HAMTEL77/Modey/case/Modey45_R2_BOTTOM_cover.step

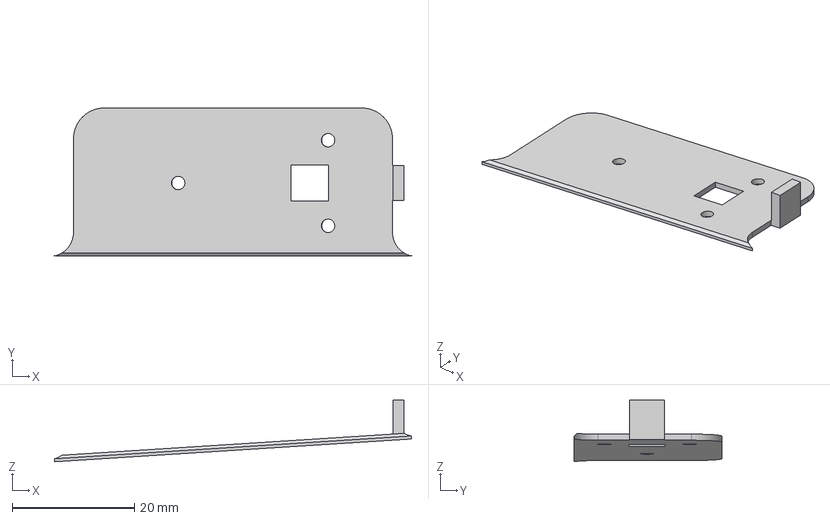
[picture p1: CAD file, 2026-07-26]
case/Modey45_R2_BOTTOM_cover.step
58.4 x 24.2 x 10.1 mm
