HAMTEL77/Modey/case/Modey45_L2_TOP.step

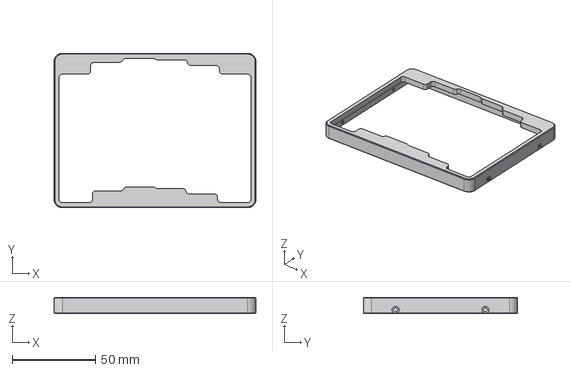
[picture p2: CAD file, 2026-07-26]
case/Modey45_L2_TOP.step
121.3 x 92.7 x 9.90 mm
