HAMTEL77/Modey/case/reset_sw.step

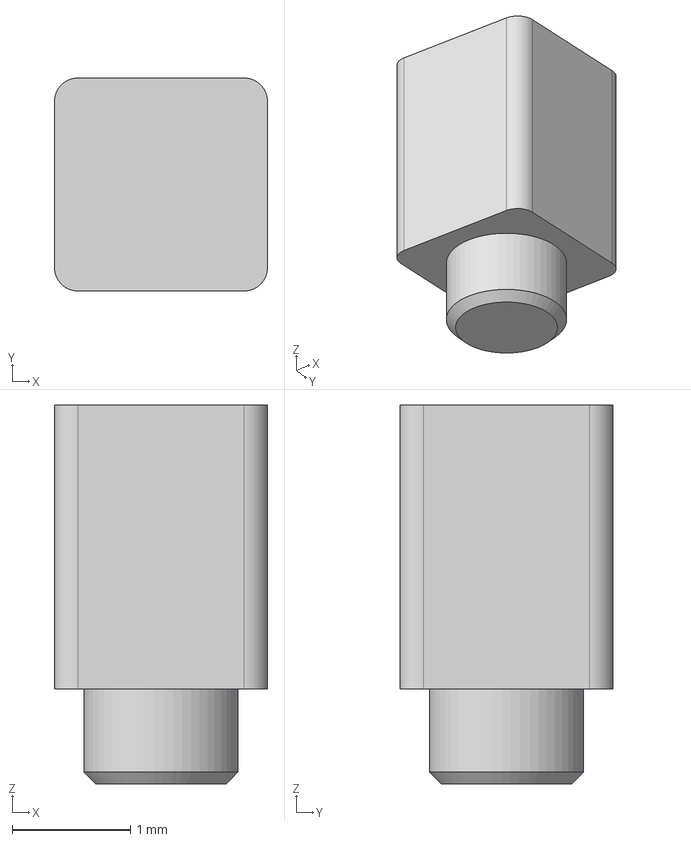
[picture p3: CAD file, 2026-07-26]
case/reset_sw.step
1.80 x 1.80 x 3.20 mm
