HAMTEL77/Modey/case/Modey45_R2_BOTTOM.step

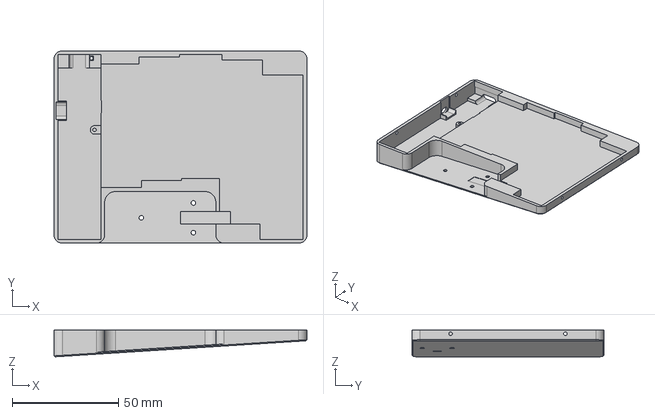
[picture p4: CAD file, 2026-07-26]
case/Modey45_R2_BOTTOM.step
119.1 x 90.5 x 12.6 mm
