HAMTEL77/Modey/case/Modey45_L2_PLATE.step

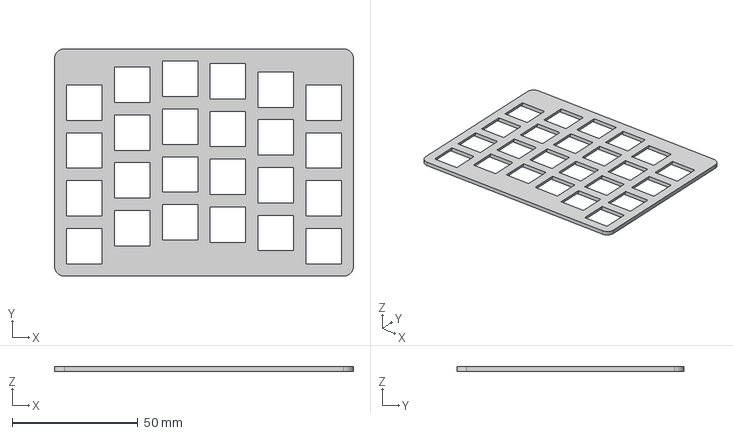
[picture p5: CAD file, 2026-07-26]
case/Modey45_L2_PLATE.step
119.1 x 90.5 x 2.00 mm
