HAMTEL77/Modey/case/power_sw.step

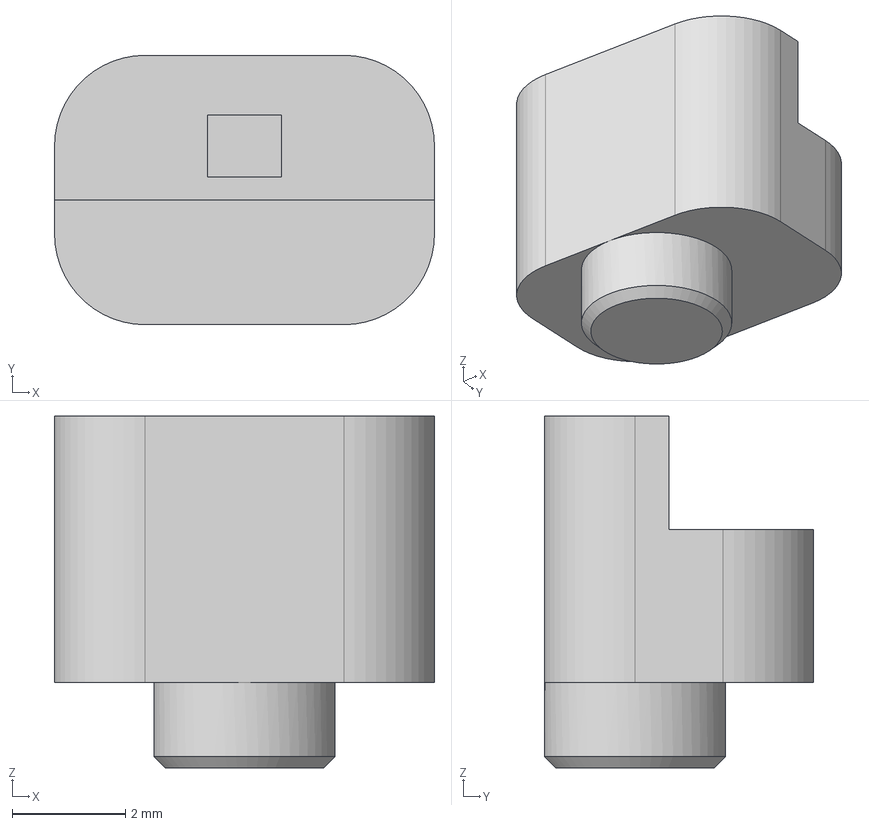
[picture p8: CAD file, 2026-07-26]
case/power_sw.step
6.70 x 4.75 x 6.20 mm
