HAMTEL77/Modey/case/19mm_C.step

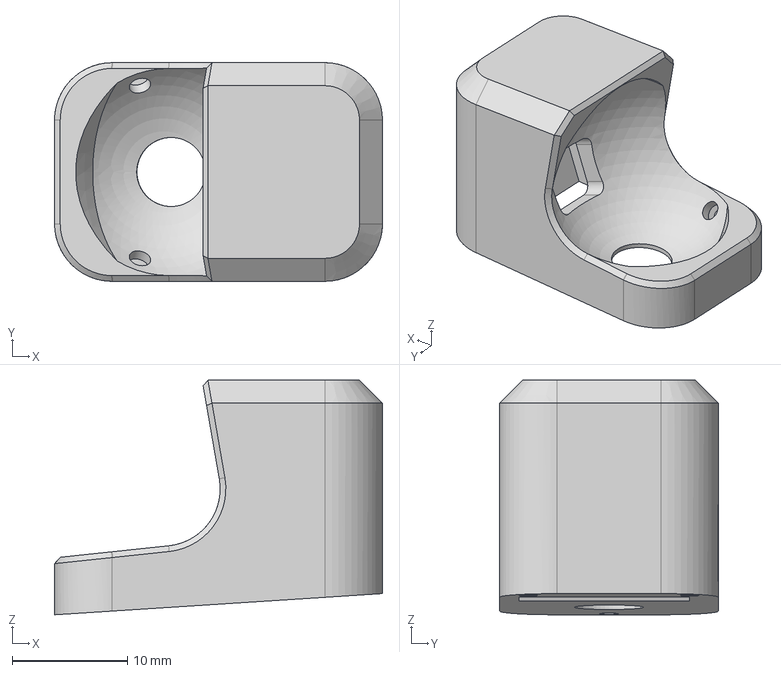
[picture p9: CAD file, 2026-07-26]
case/19mm_C.step
28.5 x 19.0 x 20.4 mm
