HAMTEL77/Modey/(list of files, cad)

Other CAD files:
case/Modey45_R2_TOP.step
