HAMTEL77/Modey/pcb/PAW3222/PAW3222.kicad_pcb

## KiCad design pcb/PAW3222/PAW3222.kicad_pcb (2026-07-26)

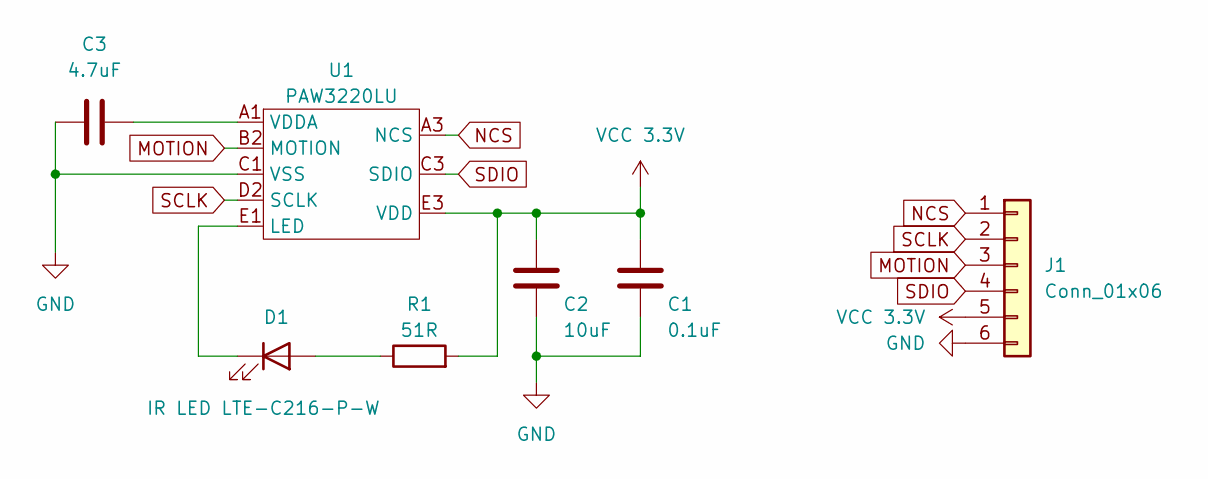
[picture p10: schematic PAW3222.kicad_sch]

Parts:
C1: 0.1uF; C_0402_1005Metric
C2: 10uF; C_0402_1005Metric
C3: 4.7uF; C_0402_1005Metric
D1: IR LED LTE-C216-P-W; LTE-C216-P-W; LCSC C2942980
J1: Conn_01x06; CONN_FH19C-6S-0.5SH10_HIR
R1: 51R; R_0402_1005Metric
U1: PAW3220LU; PAW3222LU; LCSC C9900022540

Connections:
GND: C1.2, C2.2, C3.2, J1.6, U1.C1 (VSS)
MOTION: J1.3, U1.B2 (MOTION)
NCS: J1.1, U1.A3 (NCS)
unnamed: D1.2 (A), R1.1
unnamed: D1.1 (K), U1.E1 (LED)
unnamed: C3.1, U1.A1 (VDDA)
SCLK: J1.2, U1.D2 (SCLK)
SDIO: J1.4, U1.C3 (SDIO)
VCC 3.3V: C1.1, C2.1, J1.5, R1.2, U1.E3 (VDD)

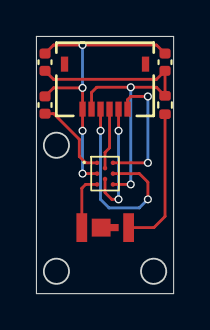
[picture p11: board PAW3222.kicad_pcb from above]

Board: 2 copper layers, 7.6 x 14.3 mm, 7 parts (0 on the bottom side), 9 nets.
