HAMTEL77/Modey/pcb/Modey45_R_keys/Modey45_R_keys.kicad_pcb

## KiCad design pcb/Modey45_R_keys/Modey45_R_keys.kicad_pcb (2026-07-26)

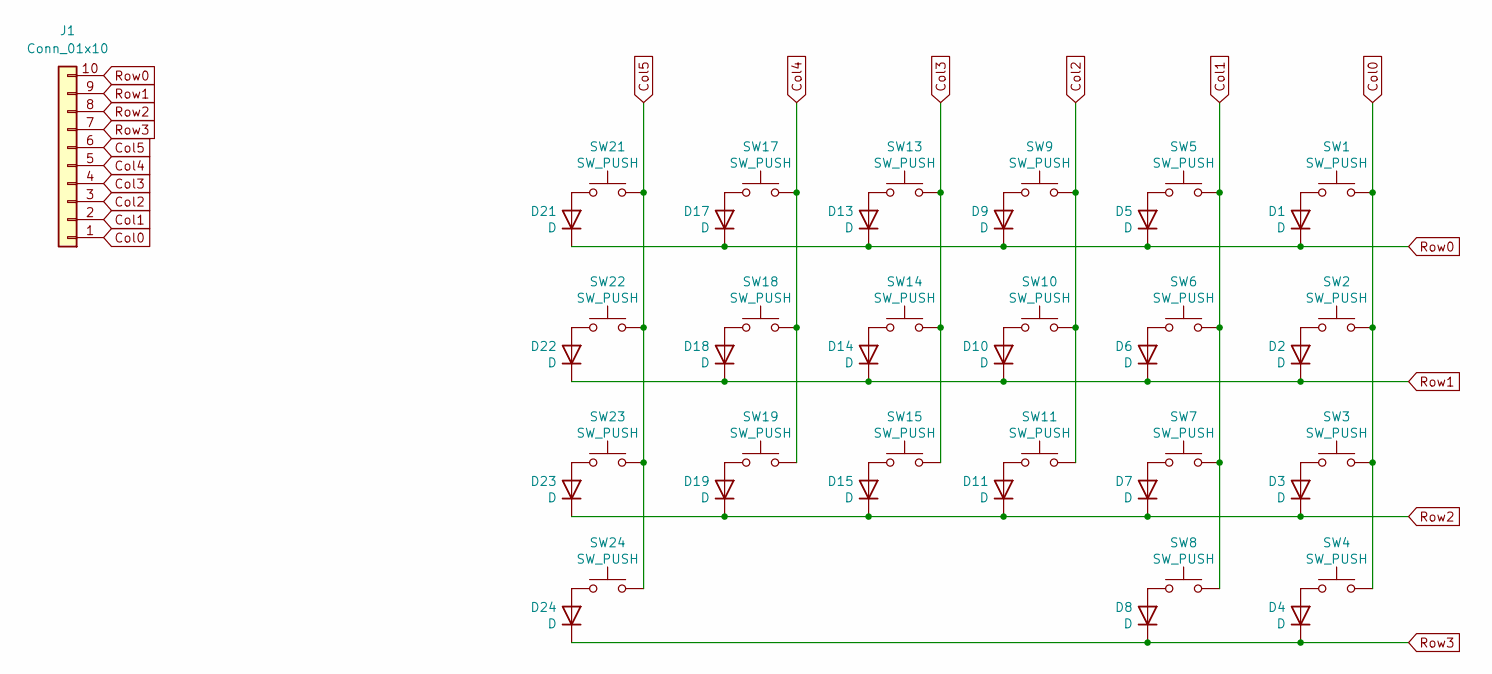
[picture p12: schematic Modey45_R_keys.kicad_sch]

Parts:
D1, D2, D3, D4, D5, D6, D7, D8, D9, D10, D11, D13, D14, D15, D17, D18, D19, D21, D22, D23, D24: D; Diode_SMD
J1: Conn_01x10; CONN_FH19C-10S-0.5SH10_HIR
SW1, SW2, SW3, SW4, SW5, SW6, SW7, SW8, SW9, SW10, SW11, SW13, SW14, SW15, SW17, SW18, SW19, SW21, SW22, SW23, SW24: SW_PUSH; SW_Choc

Connections:
Col0: J1.1, SW1.1, SW2.1, SW3.1, SW4.1
Col1: J1.2, SW5.1, SW6.1, SW7.1, SW8.1
Col2: J1.3, SW9.1, SW10.1, SW11.1
Col3: J1.4, SW13.1, SW14.1, SW15.1
Col4: J1.5, SW17.1, SW18.1, SW19.1
Col5: J1.6, SW21.1, SW22.1, SW23.1, SW24.1
unnamed: D1.2 (A), SW1.2
unnamed: D2.2 (A), SW2.2
unnamed: D3.2 (A), SW3.2
unnamed: D4.2 (A), SW4.2
unnamed: D5.2 (A), SW5.2
unnamed: D6.2 (A), SW6.2
unnamed: D7.2 (A), SW7.2
unnamed: D8.2 (A), SW8.2
unnamed: D9.2 (A), SW9.2
unnamed: D10.2 (A), SW10.2
unnamed: D11.2 (A), SW11.2
unnamed: D13.2 (A), SW13.2
unnamed: D14.2 (A), SW14.2
unnamed: D15.2 (A), SW15.2
unnamed: D17.2 (A), SW17.2
unnamed: D18.2 (A), SW18.2
unnamed: D19.2 (A), SW19.2
unnamed: D21.2 (A), SW21.2
unnamed: D22.2 (A), SW22.2
unnamed: D23.2 (A), SW23.2
unnamed: D24.2 (A), SW24.2
Row0: D1.1 (K), D5.1 (K), D9.1 (K), D13.1 (K), D17.1 (K), D21.1 (K), J1.10
Row1: D2.1 (K), D6.1 (K), D10.1 (K), D14.1 (K), D18.1 (K), D22.1 (K), J1.9
Row2: D3.1 (K), D7.1 (K), D11.1 (K), D15.1 (K), D19.1 (K), D23.1 (K), J1.8
Row3: D4.1 (K), D8.1 (K), D24.1 (K), J1.7

Board: 2 copper layers, 43 parts (1 on the bottom side), 31 nets.
