HAMTEL77/Modey/pcb/Modey45_R_controller/Modey45_R_controller.kicad_pcb

## KiCad design pcb/Modey45_R_controller/Modey45_R_controller.kicad_pcb (2026-07-26)

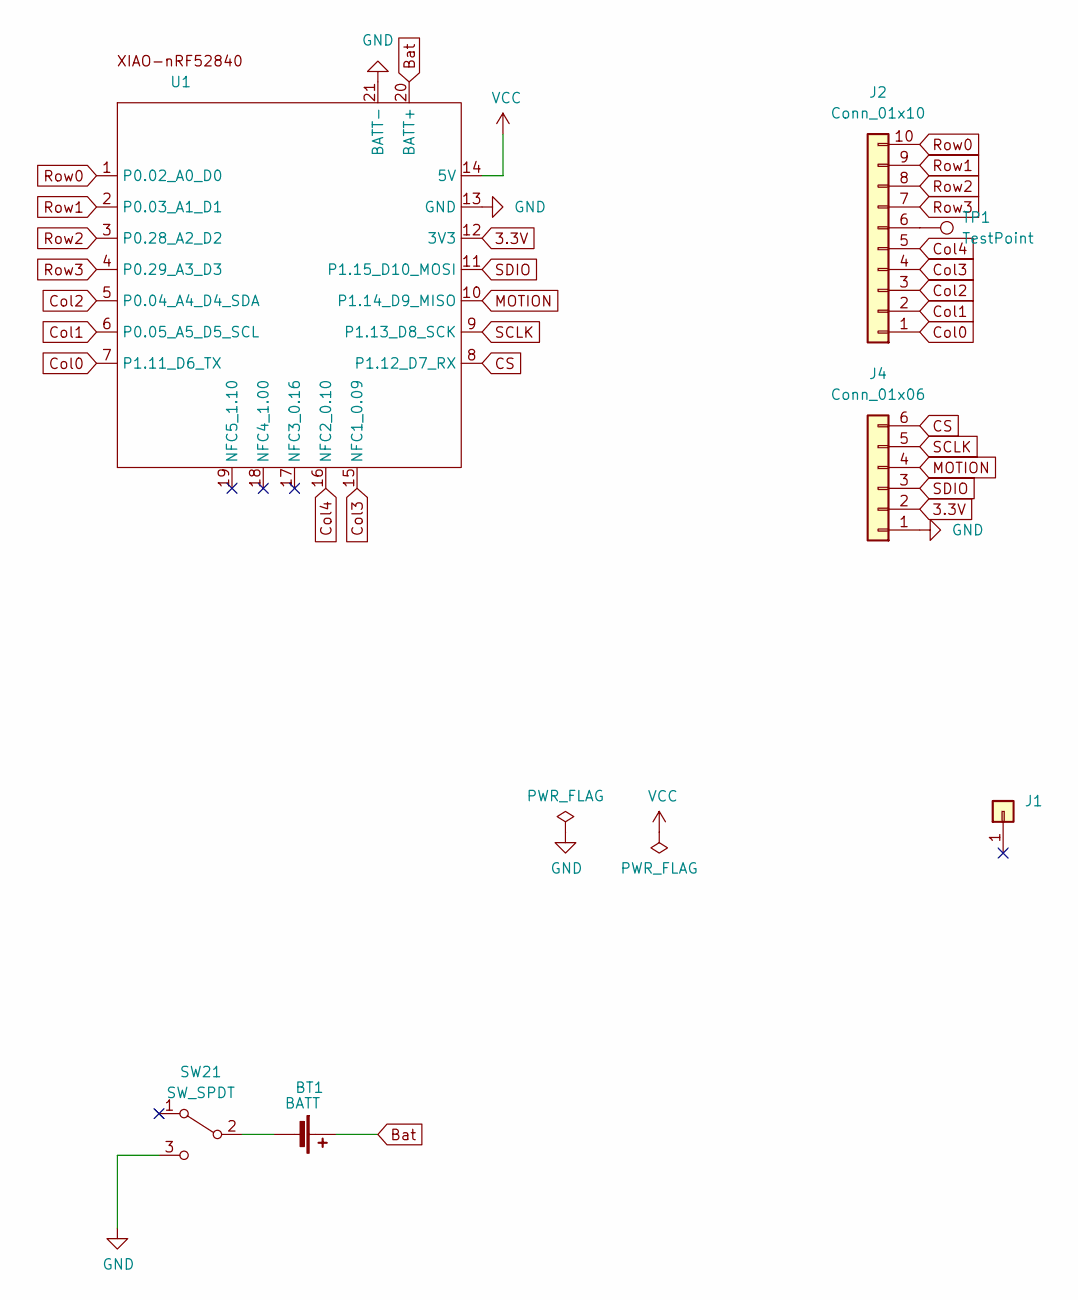
[picture p13: schematic Modey45_R_controller.kicad_sch]

Parts:
BT1: BATT; Battery_hole_2pin
J1: Conn_01x01-Connector_Generic; MountingHole_2.2mm_M2
J2: Conn_01x10; CONN_FH19C-10S-0.5SH10_HIR
J4: Conn_01x06; CONN_FH19C-6S-0.5SH10_HIR
SW21: SW_SPDT; MSK-12C02
TP1: TestPoint; TestPoint_THTPad_D1.0mm_Drill0.5mm
U1: XIAO_nRF52840_wBAT_wNFC_1

Connections:
3.3V: J4.2, U1.12 (3V3)
Bat: BT1.1 (+), U1.20 (BATT+)
CS: J4.6, U1.8 (P1.12_D7_RX)
Col0: J2.1, U1.7 (P1.11_D6_TX)
Col1: J2.2, U1.6 (P0.05_A5_D5_SCL)
Col2: J2.3, U1.5 (P0.04_A4_D4_SDA)
Col3: J2.4, U1.15 (NFC1_0.09)
Col4: J2.5, U1.16 (NFC2_0.10)
GND: J4.1, SW21.3 (C), U1.13 (GND), U1.21 (BATT-)
MOTION: J4.4, U1.10 (P1.14_D9_MISO)
unnamed: BT1.2 (-), SW21.2 (B)
unnamed: J2.6, TP1.1
Row0: J2.10, U1.1 (P0.02_A0_D0)
Row1: J2.9, U1.2 (P0.03_A1_D1)
Row2: J2.8, U1.3 (P0.28_A2_D2)
Row3: J2.7, U1.4 (P0.29_A3_D3)
SCLK: J4.5, U1.9 (P1.13_D8_SCK)
SDIO: J4.3, U1.11 (P1.15_D10_MOSI)
VCC: U1.14 (5V)

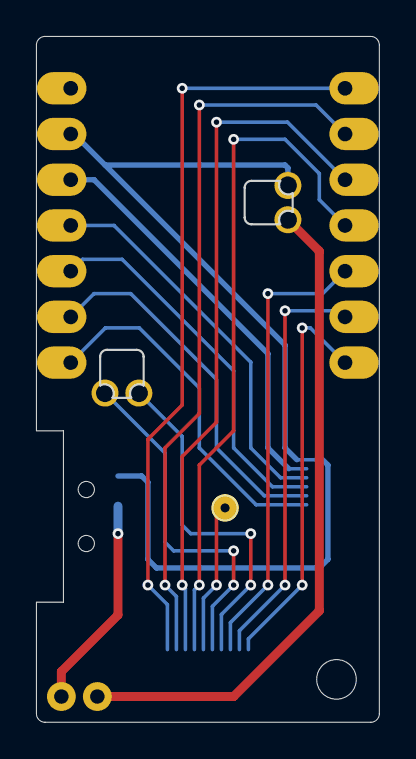
[picture p14: board Modey45_R_controller.kicad_pcb from above]

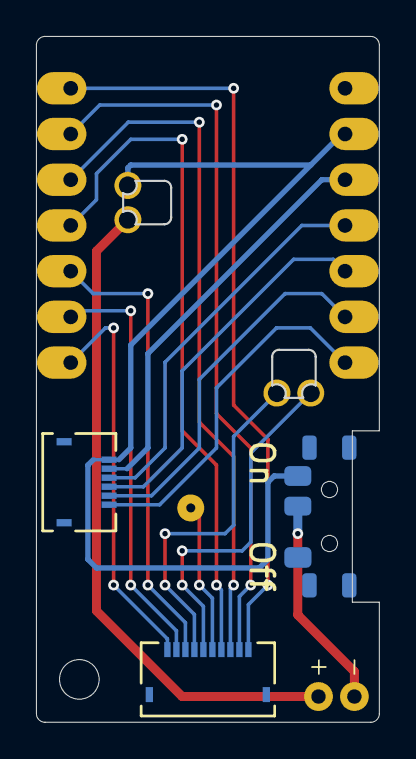
[picture p15: board Modey45_R_controller.kicad_pcb from below]

Board: 2 copper layers, 19.0 x 38.1 mm, 7 parts (5 on the bottom side), 18 nets.
